fbarak12/automated-uniaxial-tensiometer/README.md

# Automatic Uniaxial Tensiometer

1. **Repository Contents:** 
2. **System Parts:** 
3. **Software Dependencies:** 

## Repository Contents
- **Item 1:** Arduino IDE code. Sufficient to operate the entirety of the tensiometer
- **Item 2:** MATLAB script for post-data processing. Automatically generates stress vs. strain curve from raw force and elongation data 
- **Item 3:** Presentation materials as well as documentation of the entirety of the process 

## System Parts 
Parts and equipement used in our system as well as where the items can easily be found
- **Part 1:** Stepper motor & driver - $65 [Amazon Link](https://www.amazon.com/gp/product/B012QFRKAO/ref=ppx_yo_dt_b_asin_title_o05_s00?ie=UTF8&psc=1)
- **Part 2:** Arduino Microcontroller - $22 [Amazon Link](https://www.amazon.com/Arduino-A000066-ARDUINO-UNO-R3/dp/B008GRTSV6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)
- **Part 3:** 16x2 LCD Screen I2C - $8 [Amazon Link](https://www.amazon.com/ALMOCN-Display-Interface-Backlight-MEGA2560/dp/B08LYHC7CQ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)
- **Part 4:** Joystick (for navigation) - $8 [Amazon Link](https://www.amazon.com/Active-Piezo-Buzzer-Module-SunFounder/dp/B014KQLE8Q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)
- **Part 5:** 20 kg Load Cell - $8 [Amazon Link](https://www.amazon.com/Weighing-Amplifier-Pressure-Portable-Electronic/dp/B09NNYFY3F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)

## Software Dependencies
- **Dependency 1:** AccelStepper; Arduino Library - Open source library available on Arduino IDE allowing easy control over virtually any stepper motor connected to your microcontroller 
- **Dependency 2:** LiquidCrstal; Arduino Library - Open source library available on Arduino IDE allowing easy control over non-I2C LCD screens

Farid Barak, Alex Reyes, Lee Kihyun, Nour El Banna
